Rish-736/fhss-anti-jam-telemetry/paper/figures/fig7_sensing.png

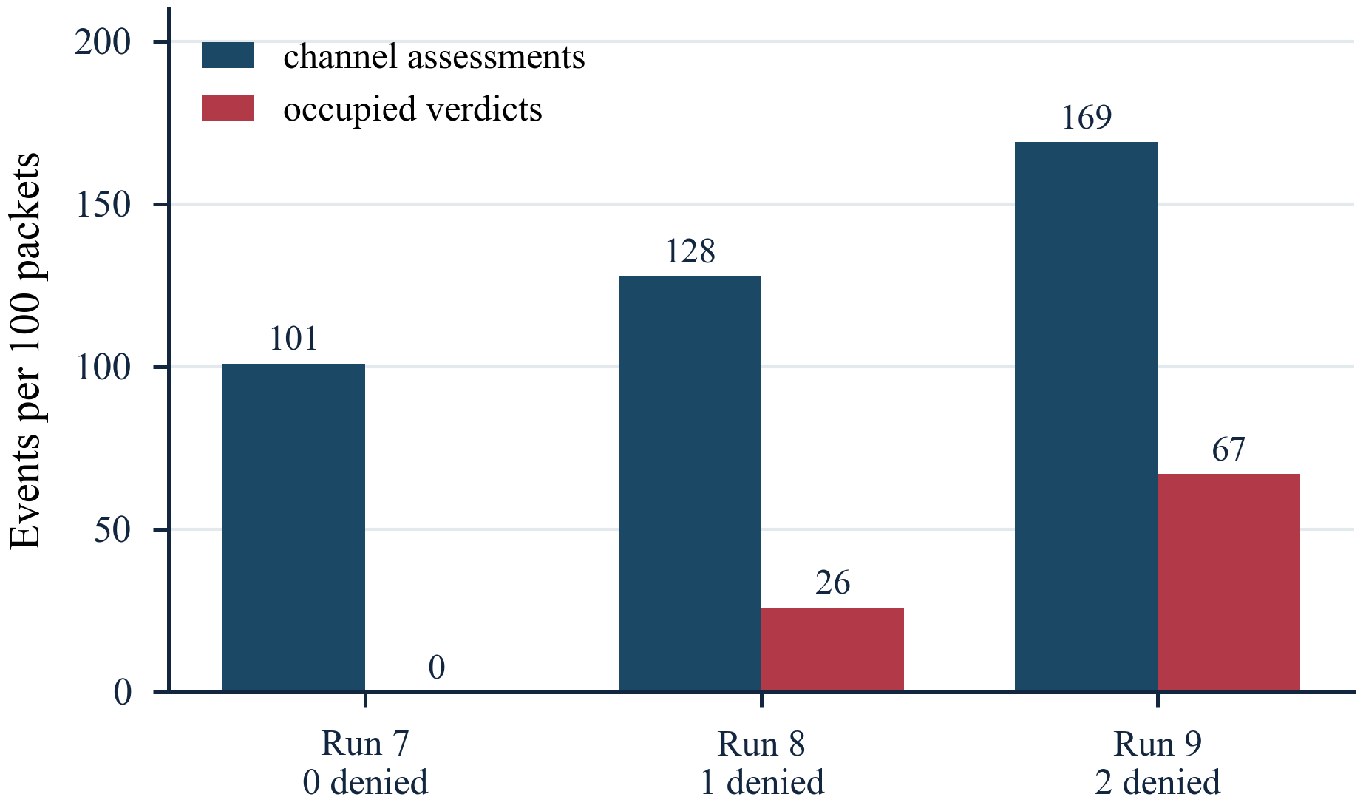
paper/figures/fig7_sensing.png
