Rish-736/fhss-anti-jam-telemetry/results/fig1_loss_vs_denial.png

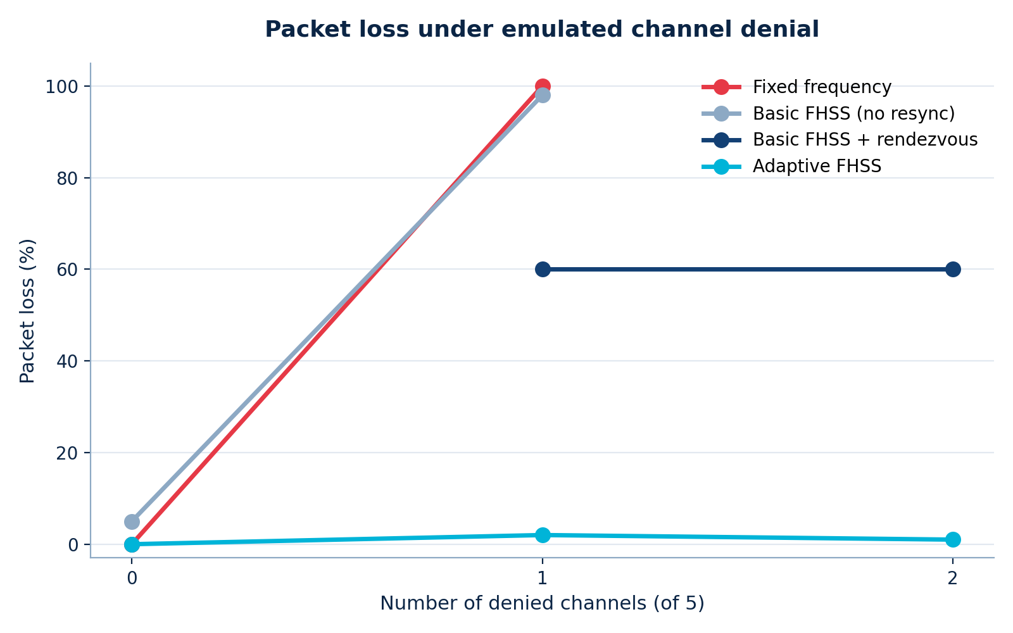
results/fig1_loss_vs_denial.png
