Rish-736/fhss-anti-jam-telemetry/results/fig2_mode_comparison.png

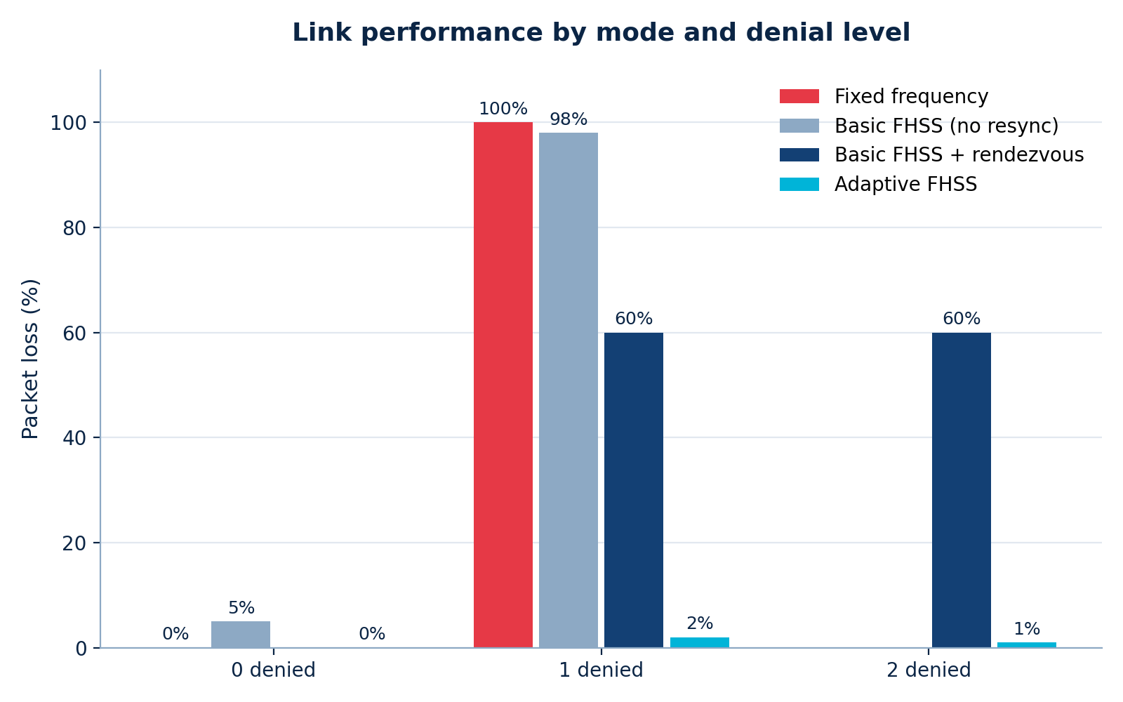
results/fig2_mode_comparison.png
