Rish-736/fhss-anti-jam-telemetry/results/fig3_rssi.png

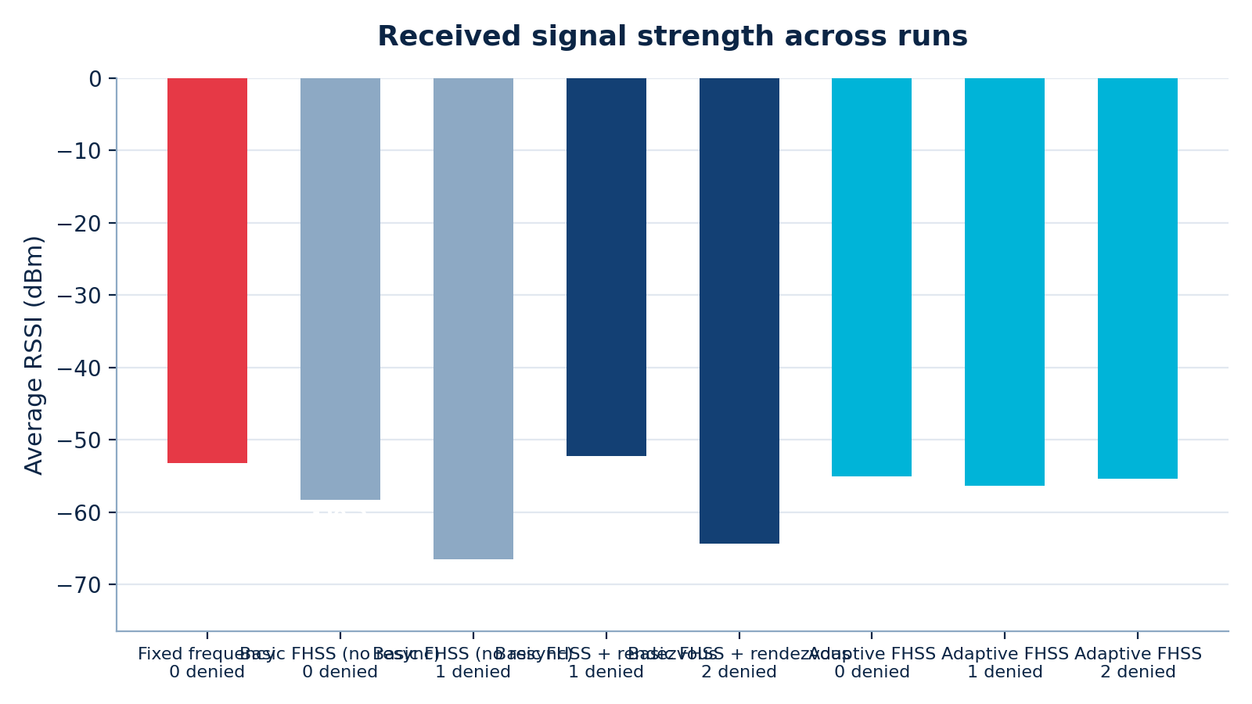
results/fig3_rssi.png
